useraid/MangonelProject/Pictures/EDP (1).jpeg

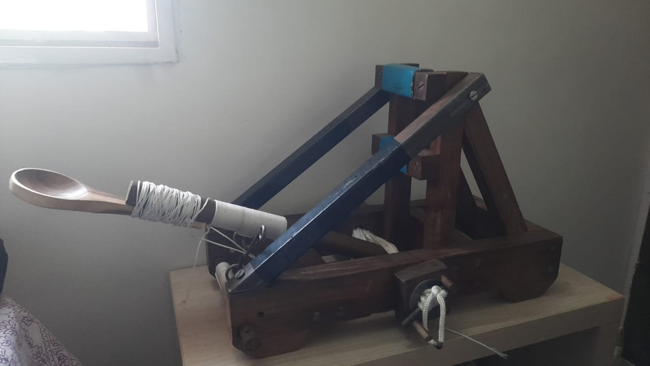
Pictures/EDP (1).jpeg
