useraid/MangonelProject/Pictures/EDP (4).jpeg

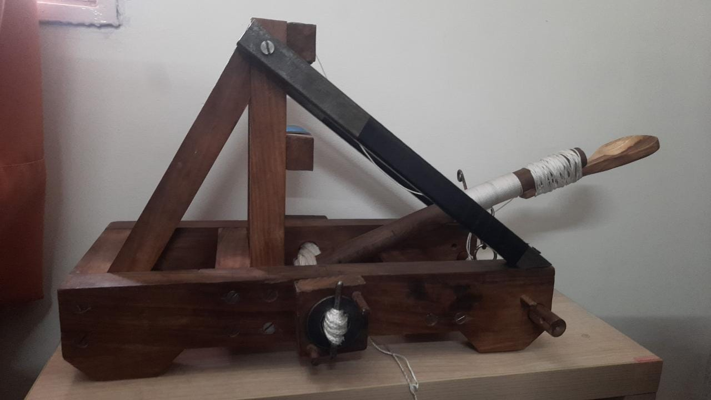
Pictures/EDP (4).jpeg
