useraid/MangonelProject/README.md

# Mangonel Project (UTA016) TIET

Code and designs for the mangonel project - UTA016.

All the code was implemented on a *Arduino UNO*.
