useraid/MangonelProject/Pictures/EDP (1).jpg

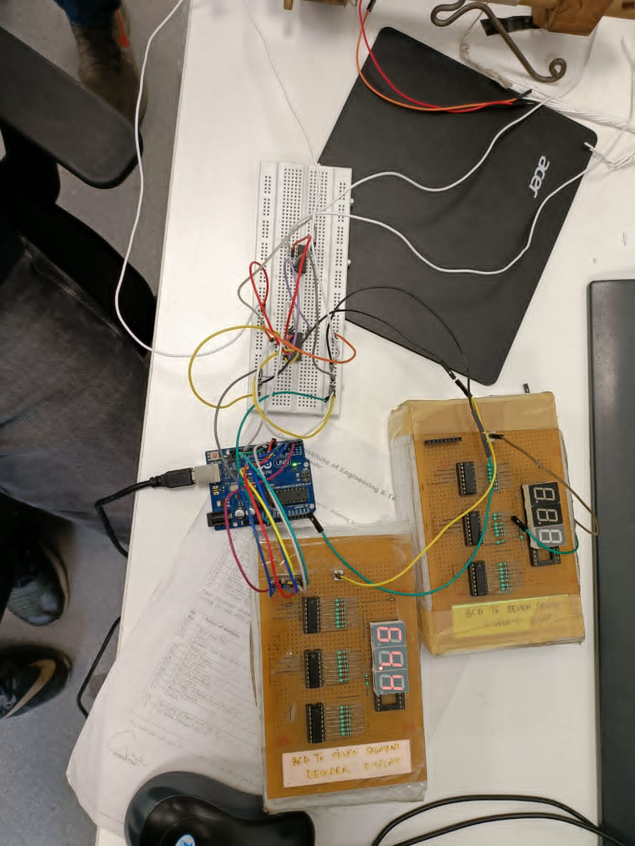
Pictures/EDP (1).jpg
