useraid/MangonelProject/Pictures/EDP (2).jpeg

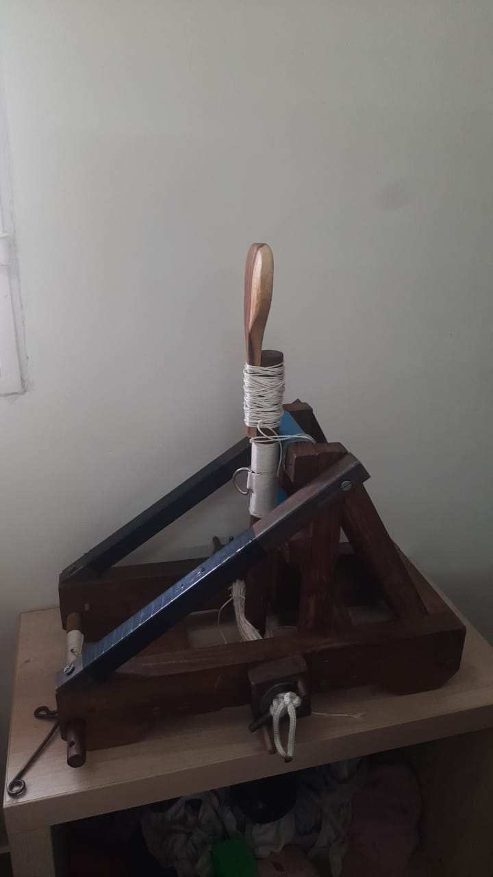
Pictures/EDP (2).jpeg
