useraid/MangonelProject/Pictures/EDP (3).jpeg

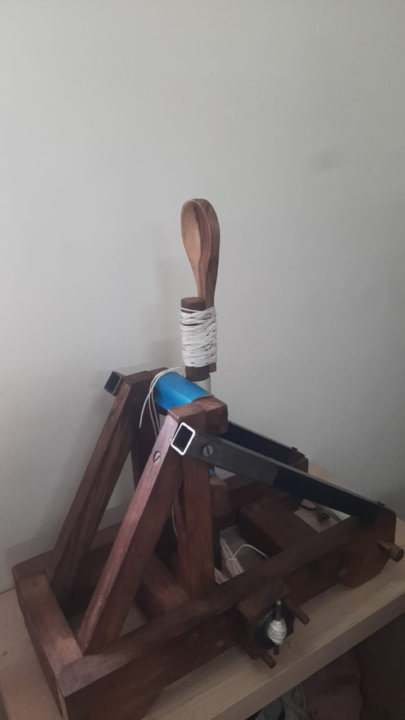
Pictures/EDP (3).jpeg
