useraid/MangonelProject/Pictures/EDP (5).jpeg

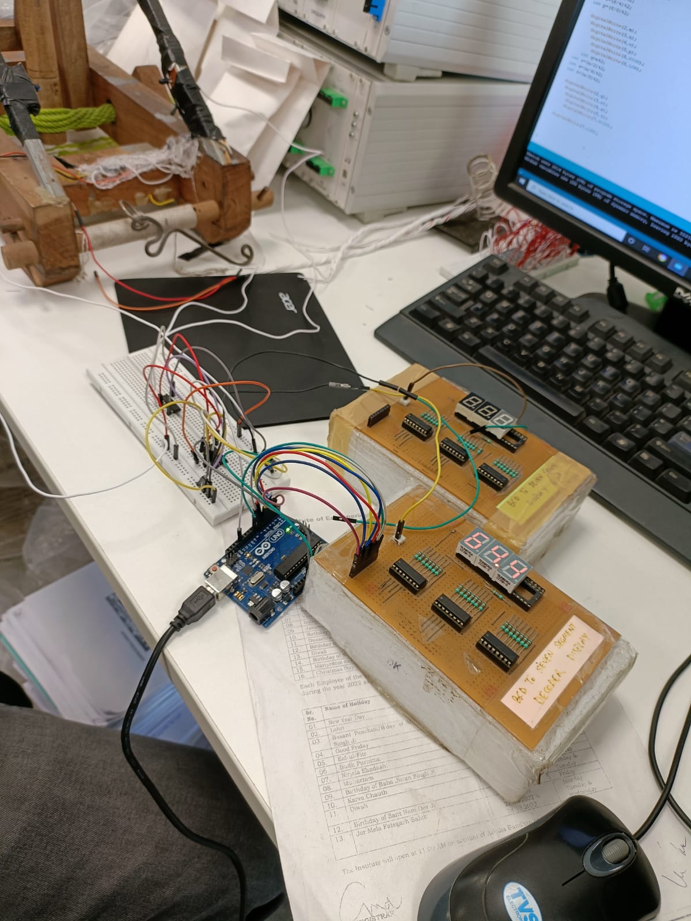
Pictures/EDP (5).jpeg
