useraid/MangonelProject/Pictures/EDP (6).jpeg

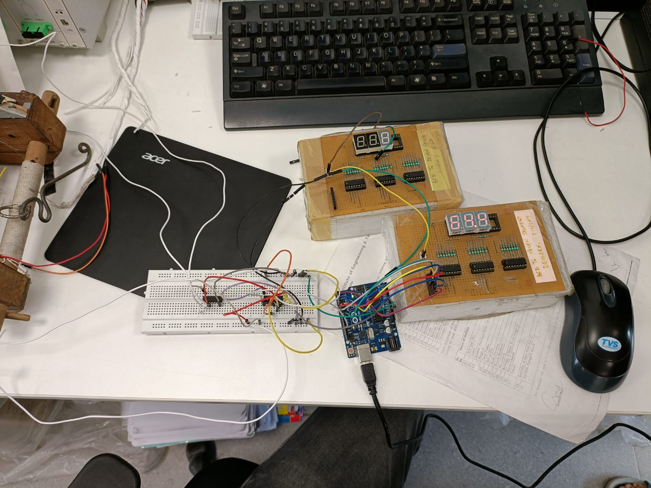
Pictures/EDP (6).jpeg
