useraid/MangonelProject/Pictures/EDP (7).jpeg

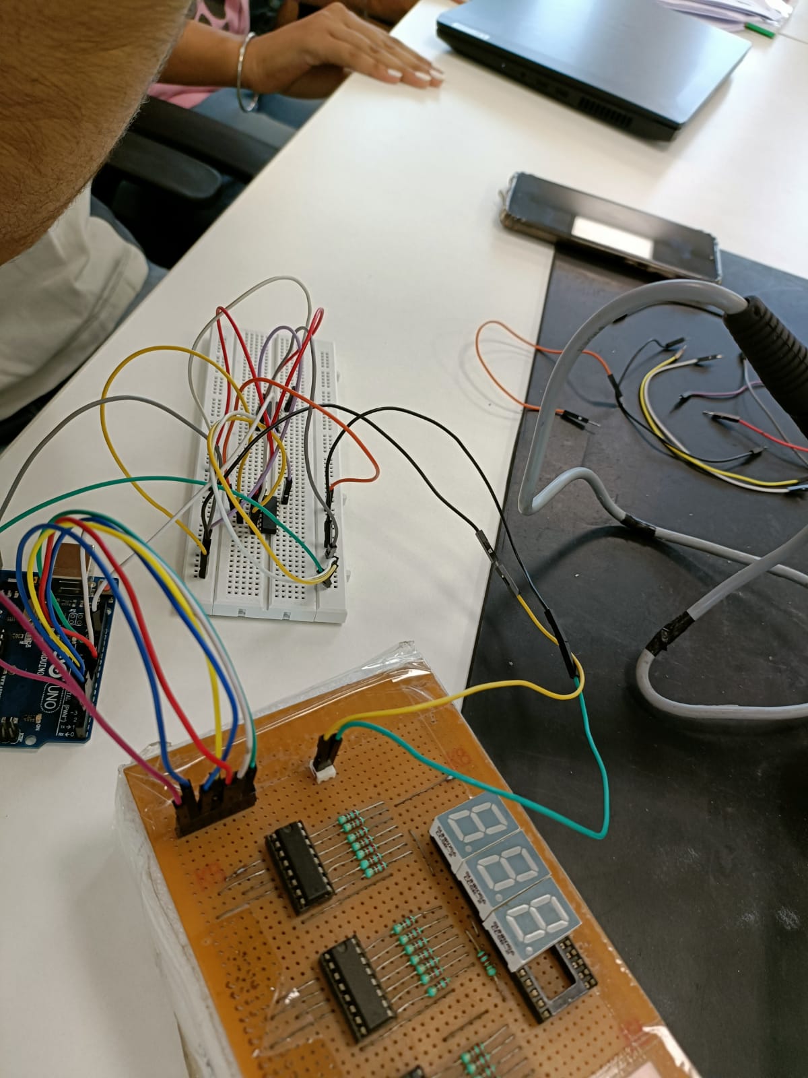
Pictures/EDP (7).jpeg
