useraid/MangonelProject/Pictures/EDP (8).jpeg

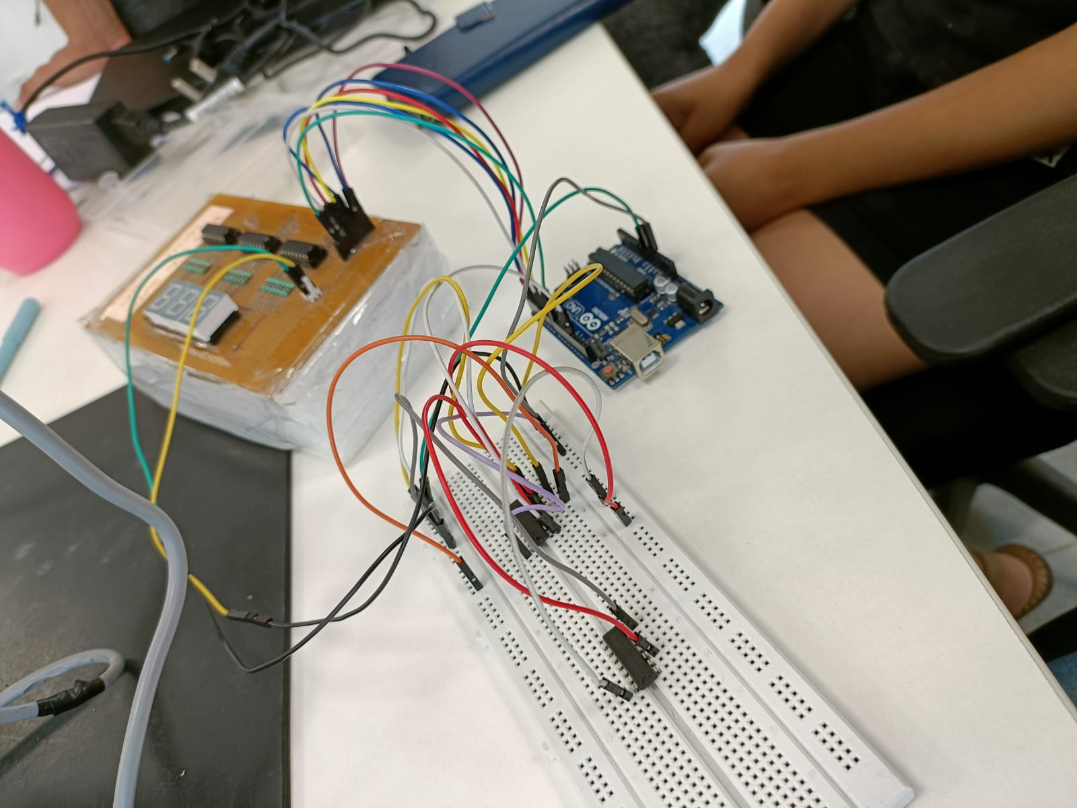
Pictures/EDP (8).jpeg
