useraid/MangonelProject/Pictures/EDP (9).jpeg

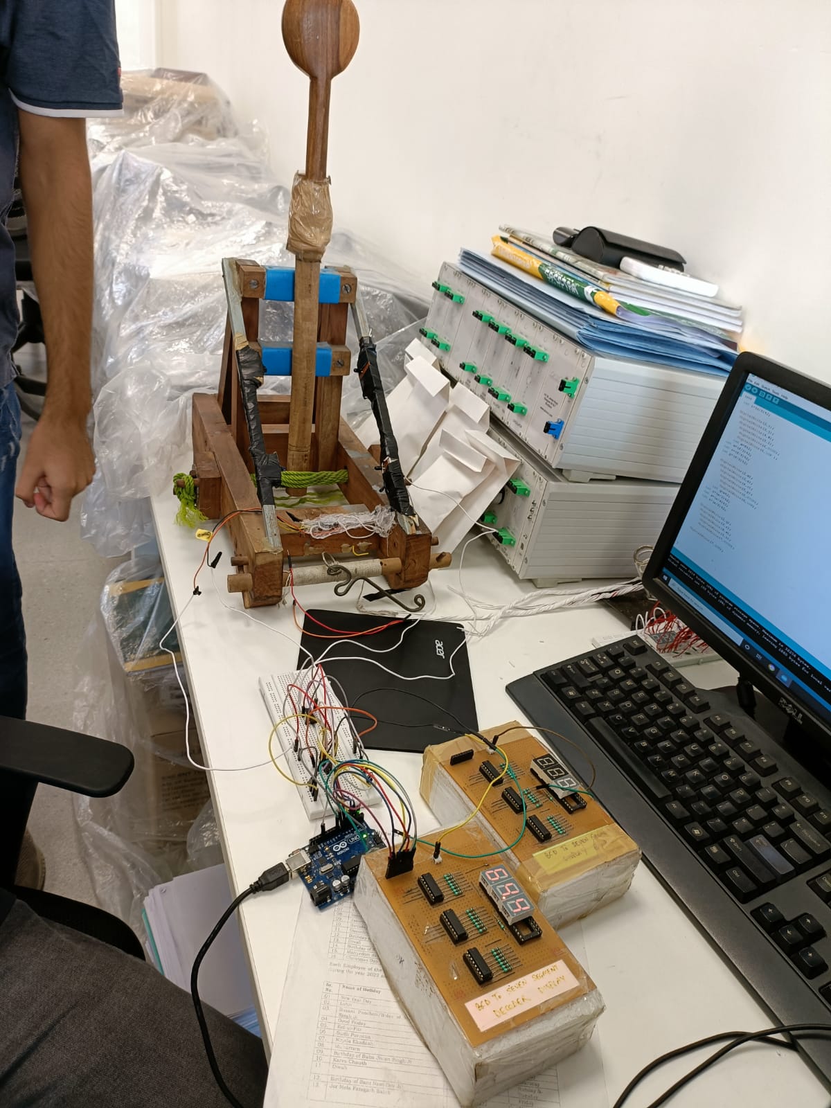
Pictures/EDP (9).jpeg
