useraid/MangonelProject/Pictures/EDP (10).jpeg

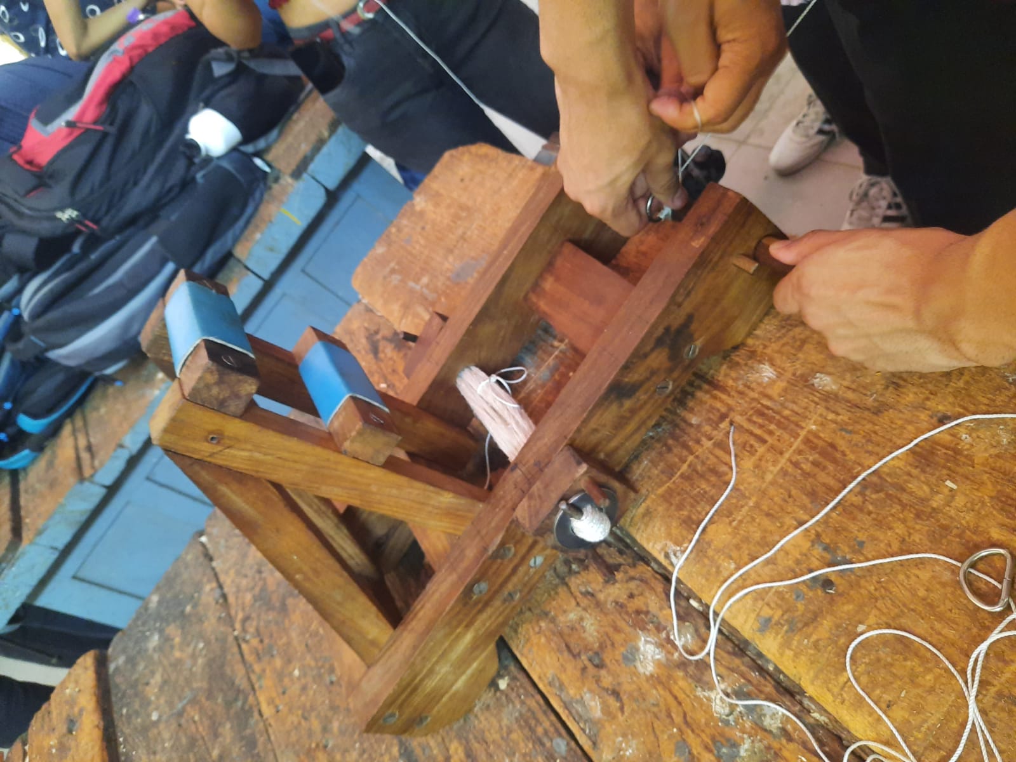
Pictures/EDP (10).jpeg
