useraid/MangonelProject/Pictures/EDP (11).jpeg

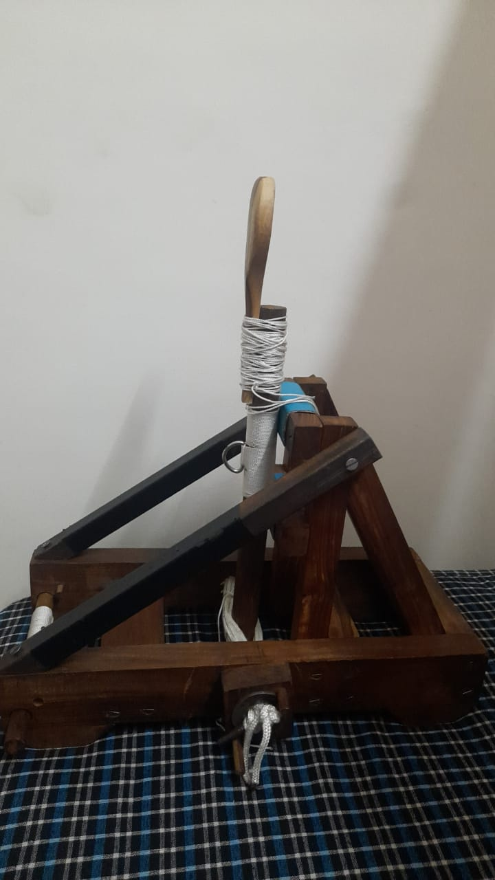
Pictures/EDP (11).jpeg
