useraid/MangonelProject/Pictures/EDP (12).jpeg

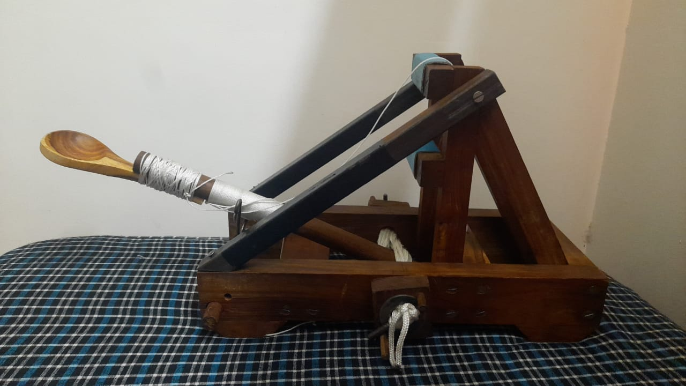
Pictures/EDP (12).jpeg
