useraid/MangonelProject/Pictures/EDP (13).jpeg

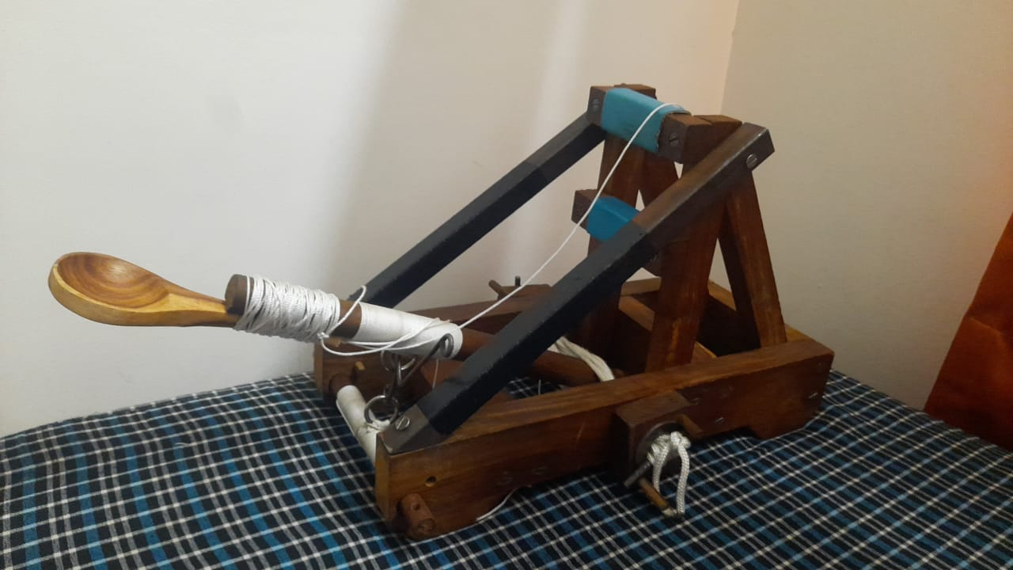
Pictures/EDP (13).jpeg
