useraid/MangonelProject/Pictures/EDP (14).png

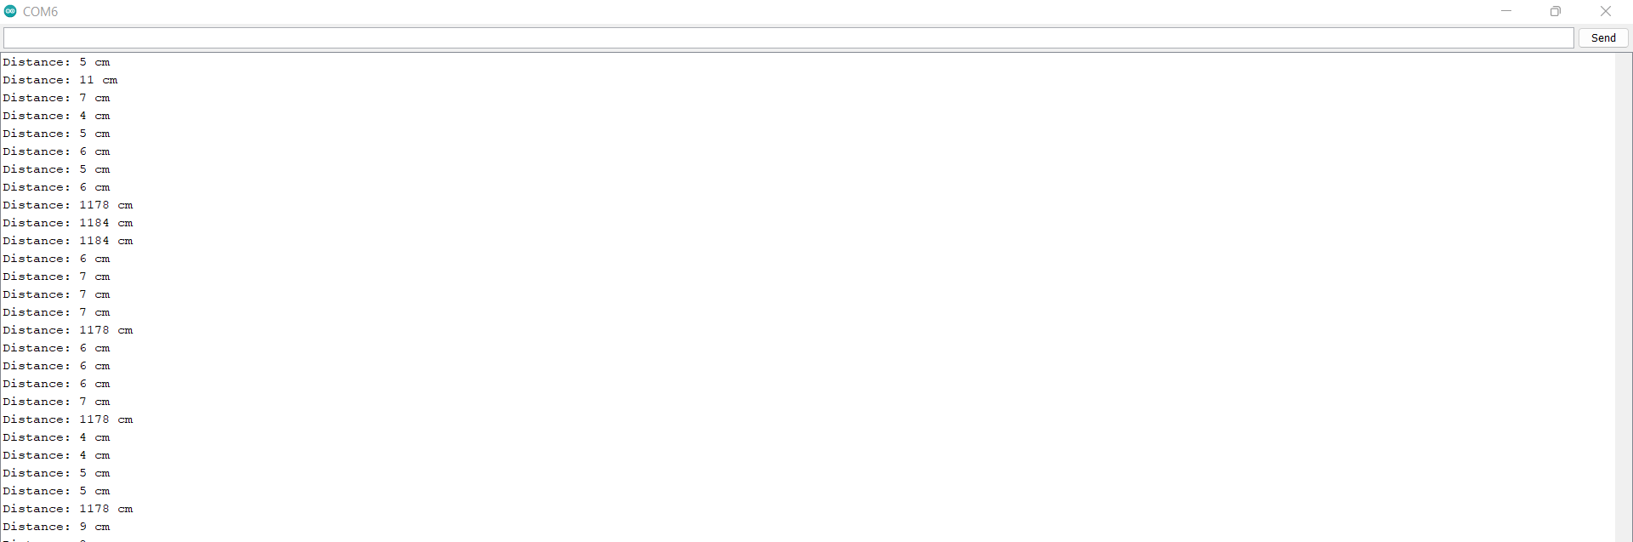
Pictures/EDP (14).png
